kmani314/wearables/watch/pretty/CM7V-XTAL/CM7V-T1A-32.768kHz-6pF-20PPM-TA-QC/3D/CM7V-T1A-32.768kHz-6pF-20PPM-TA-QC.stp

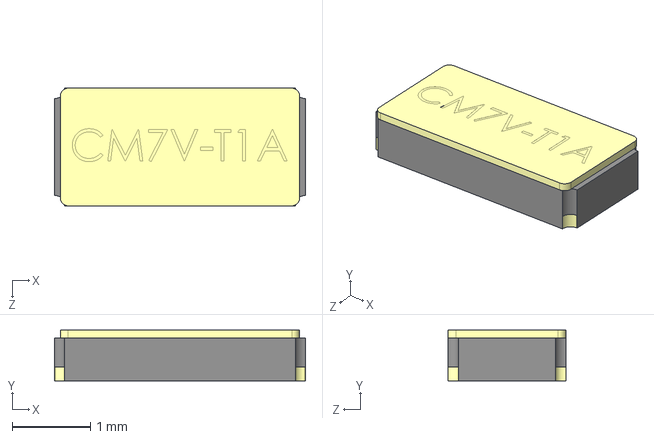
[picture p1: CAD file, 2023-06-11]
watch/pretty/CM7V-XTAL/CM7V-T1A-32.768kHz-6pF-20PPM-TA-QC/3D/CM7V-T1A-32.768kHz-6pF-20PPM-TA-QC.stp
3.20 x 0.65 x 1.50 mm
