kmani314/wearables/watch/pretty/EVP-ATAL1B000/3D/EVP-ATAL1B000.stp

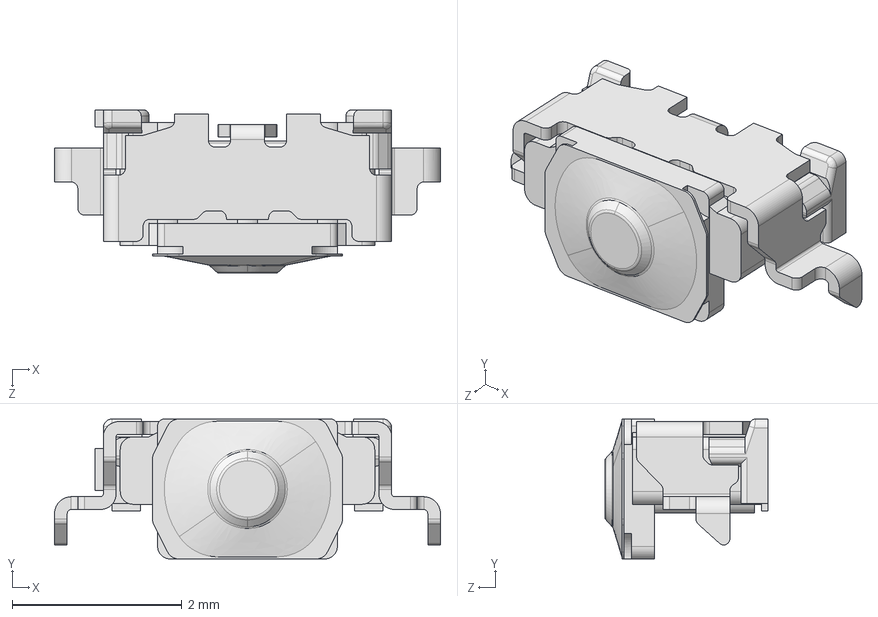
[picture p2: CAD file, 2023-06-11]
watch/pretty/EVP-ATAL1B000/3D/EVP-ATAL1B000.stp
4.55 x 1.65 x 1.93 mm
