kmani314/wearables/watch/pretty/FA-128_32.0000MF10Z-AJ5/3D/FA-128_32.0000MF10Z-AJ5.stp

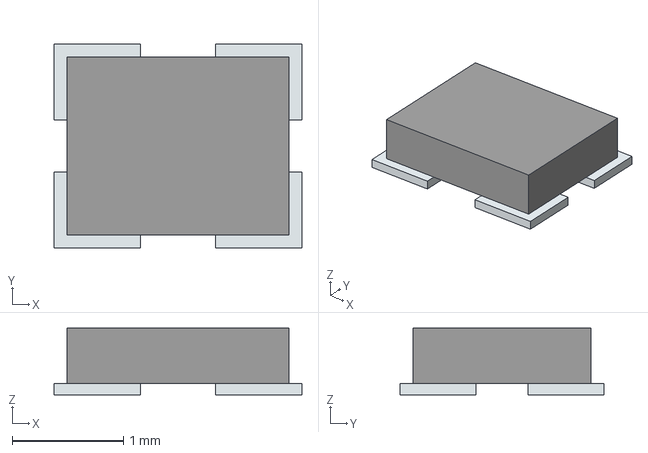
[picture p3: CAD file, 2023-06-11]
watch/pretty/FA-128_32.0000MF10Z-AJ5/3D/FA-128_32.0000MF10Z-AJ5.stp
2.23 x 1.83 x 0.6 mm
Pins
