kmani314/wearables/watch/pretty/MAX-M10S-00B/MAX-M10S-00B/3D/MAX-M10S-00B.stp

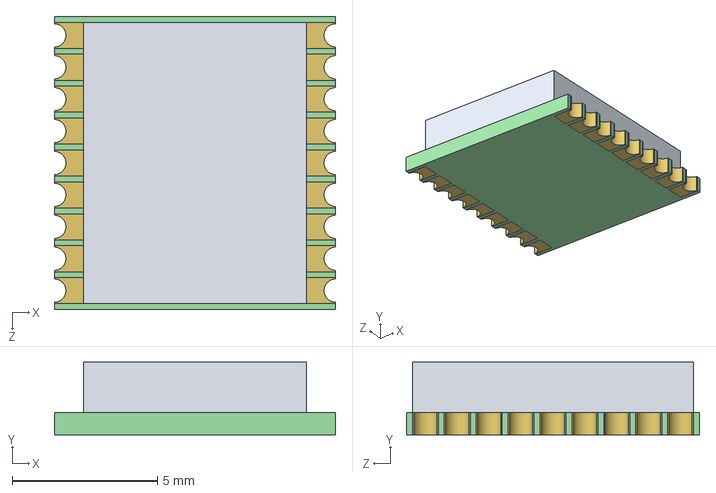
[picture p4: CAD file, 2023-06-11]
watch/pretty/MAX-M10S-00B/MAX-M10S-00B/3D/MAX-M10S-00B.stp
9.70 x 2.50 x 10.1 mm
