kmani314/wearables/watch/pretty/TXS0108ERGYR/TXS0108ERGYR/3D/TXS0108ERGYR.stp

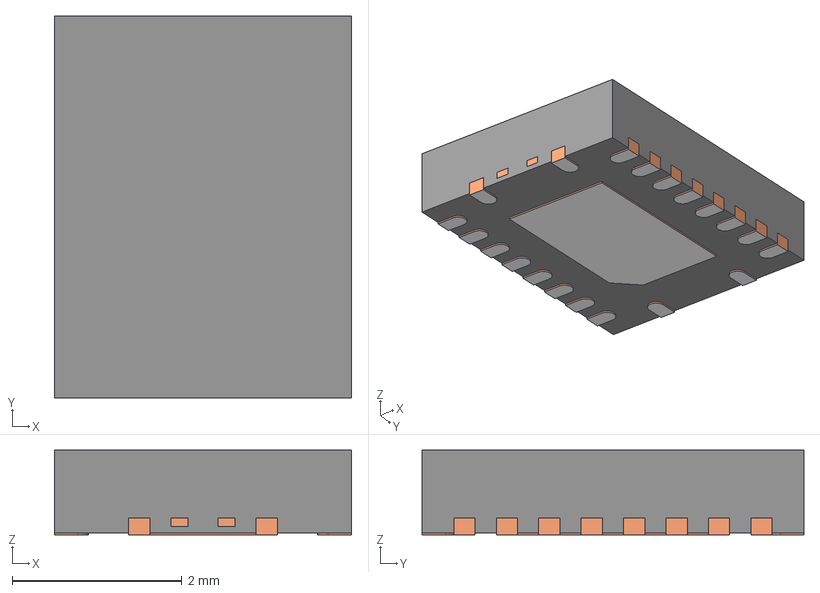
[picture p5: CAD file, 2023-06-09]
watch/pretty/TXS0108ERGYR/TXS0108ERGYR/3D/TXS0108ERGYR.stp
3.50 x 4.50 x 1.00 mm
BODY-QFN
FRAME-RGY0020A
PIN1-ID
