kmani314/wearables/watch/pretty/type-c-31-m-12/TYPE-C-31-M-12.step

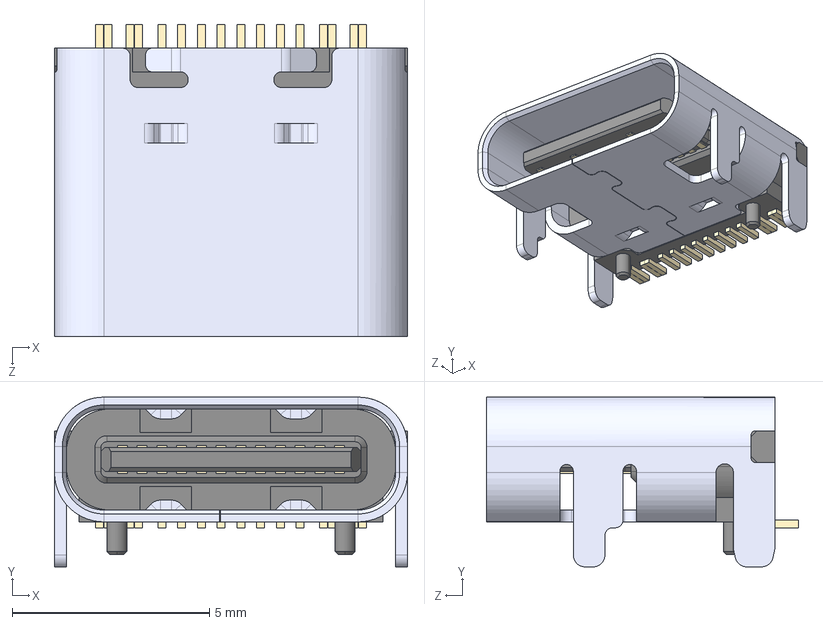
[picture p6: CAD file, 2023-06-08]
watch/pretty/type-c-31-m-12/TYPE-C-31-M-12.step
8.94 x 4.30 x 7.90 mm
