kmani314/wearables/watch/pretty/VEMD5080X01/VEMD5080X01/3D/VEMD5080X01.stp

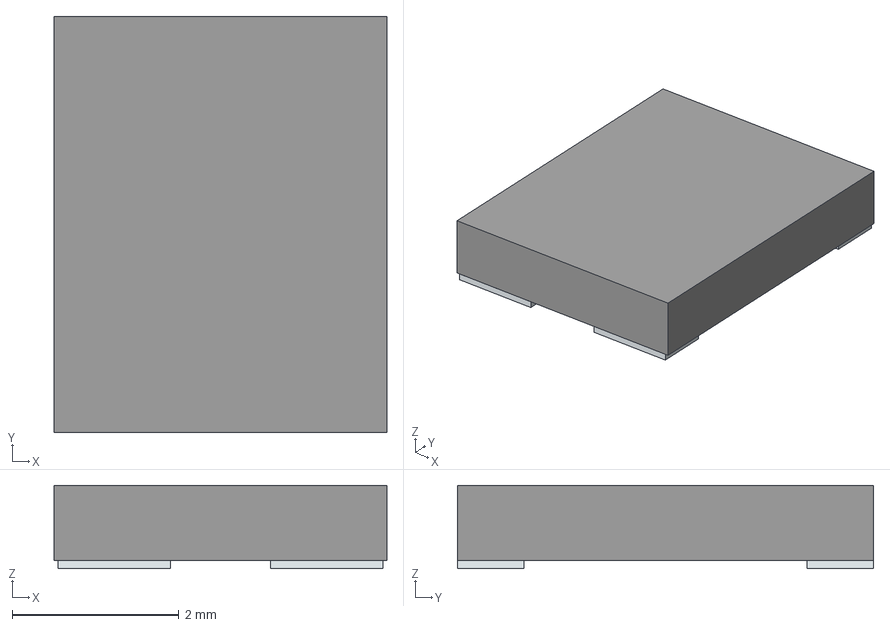
[picture p7: CAD file, 2023-06-08]
watch/pretty/VEMD5080X01/VEMD5080X01/3D/VEMD5080X01.stp
4.00 x 5.00 x 1.00 mm
Pins
