kmani314/wearables/watch/pretty/MAX31341CETB+T/3D/MAX31341CETB+T.stp

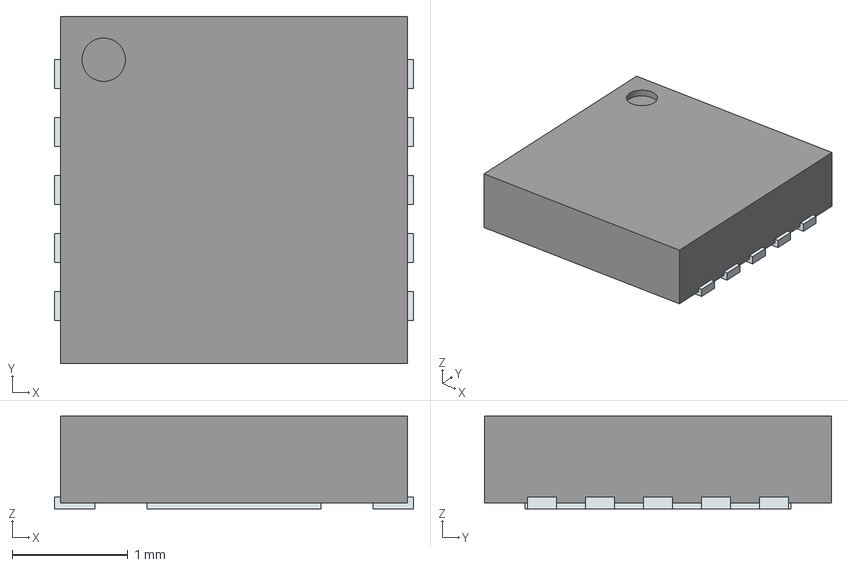
[picture p8: CAD file, 2023-06-13]
watch/pretty/MAX31341CETB+T/3D/MAX31341CETB+T.stp
3.10 x 3.00 x 0.8 mm
ThermalPin
PinsArrayLR
