kmani314/wearables/watch/pretty/max77659aenv+/MAX77659AENV+/3D/MAX77659AENV+.stp

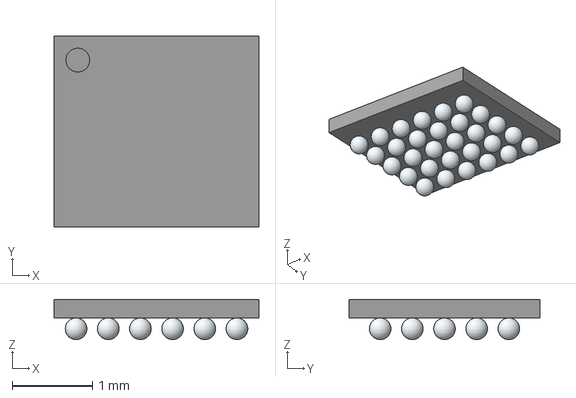
[picture p9: CAD file, 2023-06-08]
watch/pretty/max77659aenv+/MAX77659AENV+/3D/MAX77659AENV+.stp
2.55 x 2.37 x 0.5 mm
