kmani314/wearables/watch/pretty/max86141/MAX86141ENP+T/3D/MAX86141ENP+T.stp

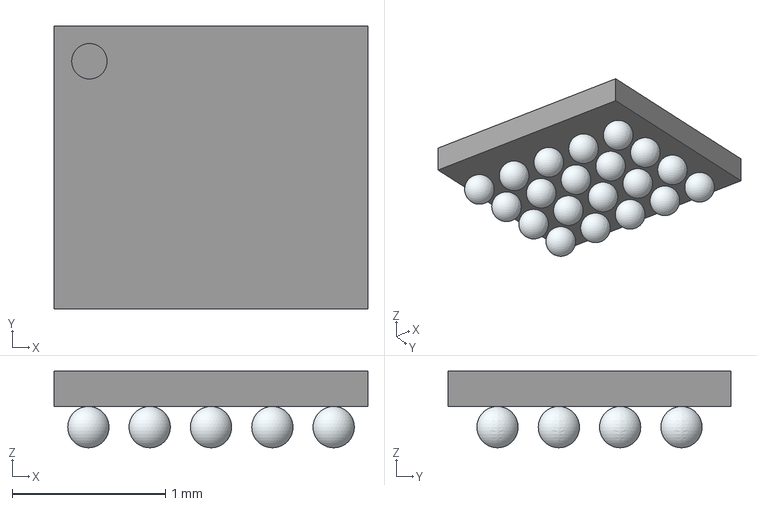
[picture p10: CAD file, 2023-06-08]
watch/pretty/max86141/MAX86141ENP+T/3D/MAX86141ENP+T.stp
2.05 x 1.85 x 0.5 mm
