kmani314/wearables/watch/pretty/molex_505110-2291/505110-2291/3D/505110-2291.stp

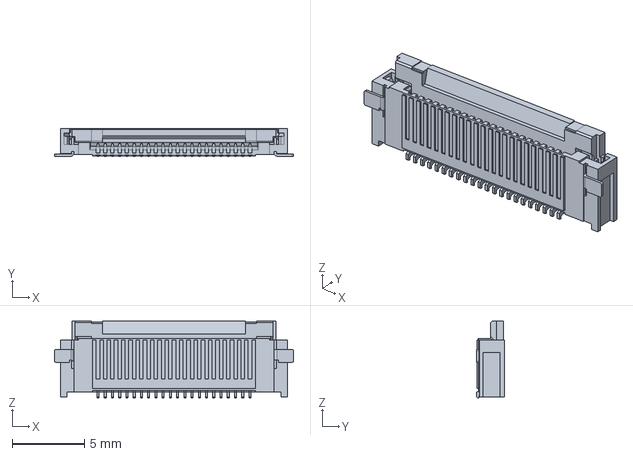
[picture p11: CAD file, 2023-06-08]
watch/pretty/molex_505110-2291/505110-2291/3D/505110-2291.stp
16.5 x 1.90 x 5.30 mm
