kmani314/wearables/(list of files, cad)

Other CAD files:
watch/pretty/CM7V-XTAL/CM7V-T1A-32.768kHz-6pF-20PPM-TA-QC/Allegro/cm7v32768tbqa020.psm
watch/pretty/CM7V-XTAL/CM7V-T1A-32.768kHz-6pF-20PPM-TA-QC/DEHDL/cm7v_t1a_32.768khz_6pf_20ppm_ta_qc/chips/chips.prt
watch/pretty/EVP-ATAL1B000/Allegro/evpatal1b000.psm
watch/pretty/EVP-ATAL1B000/DEHDL/evp_atal1b000/chips/chips.prt
watch/pretty/FA-128_32.0000MF10Z-AJ5/Allegro/fa128320000mf10zaj5.psm
watch/pretty/FA-128_32.0000MF10Z-AJ5/DEHDL/fa_128_32.0000mf10z_aj5/chips/chips.prt
watch/pretty/MAX-M10S-00B/MAX-M10S-00B/Allegro/maxm10s00b.psm
watch/pretty/MAX-M10S-00B/MAX-M10S-00B/DEHDL/max_m10s_00b/chips/chips.prt
watch/pretty/MAX31341CETB+T/Allegro/son50p300x300x80-11n.psm
watch/pretty/MAX31341CETB+T/DEHDL/max31341cetb_t/chips/chips.prt
watch/pretty/TXS0108ERGYR/TXS0108ERGYR/Allegro/sn74lvc541argyr.psm
watch/pretty/TXS0108ERGYR/TXS0108ERGYR/DEHDL/txs0108ergyr/chips/chips.prt
watch/pretty/VEMD5080X01/VEMD5080X01/Allegro/vemd5080x01.psm
watch/pretty/VEMD5080X01/VEMD5080X01/DEHDL/vemd5080x01/chips/chips.prt
watch/pretty/VLMO20J2M1/VLMO20J2M1-GS08/Allegro/ledm2214x140n.psm
watch/pretty/VLMO20J2M1/VLMO20J2M1-GS08/DEHDL/vlmo20j2m1_gs08/chips/chips.prt
watch/pretty/max32264/MAX32664GTGC+T/Allegro/max32664gtgc.psm
watch/pretty/max32264/MAX32664GTGC+T/DEHDL/max32664gtgc_t/chips/chips.prt
watch/pretty/max77659aenv+/MAX77659AENV+/Allegro/bga30c40p6x5_255x237x50.psm
watch/pretty/max77659aenv+/MAX77659AENV+/DEHDL/max77659aenv_/chips/chips.prt
watch/pretty/max86141/MAX86141ENP+T/Allegro/bga20c40p5x4_205x185x50.psm
watch/pretty/max86141/MAX86141ENP+T/DEHDL/max86141enp_t/chips/chips.prt
watch/pretty/molex_505110-2291/505110-2291/Allegro/5051102291.psm
watch/pretty/molex_505110-2291/505110-2291/DEHDL/505110_2291/chips/chips.prt
