kmani314/wearables/(list of files, drawings)

Other design files:
watch/pretty/EVP-ATAL1B000/Altium/EVP-ATAL1B000.SchLib
watch/pretty/EVP-ATAL1B000/Altium/EVPATAL1B000.PcbLib
watch/pretty/FA-128_32.0000MF10Z-AJ5/Altium/FA128320000MF10ZAJ5.PcbLib
watch/pretty/FA-128_32.0000MF10Z-AJ5/Altium/FA-128_32.0000MF10Z-AJ5.SchLib
watch/pretty/MAX31341CETB+T/Altium/MAX31341CETB+T.SchLib
watch/pretty/MAX31341CETB+T/Altium/SON50P300X300X80-11N.PcbLib
watch/pretty/max77659aenv+/MAX77659AENV+/Altium/BGA30C40P6X5_255X237X50.PcbLib
watch/pretty/max77659aenv+/MAX77659AENV+/Altium/MAX77659AENV+.SchLib
watch/pretty/max86141/MAX86141ENP+T/Altium/BGA20C40P5X4_205X185X50.PcbLib
watch/pretty/max86141/MAX86141ENP+T/Altium/MAX86141ENP+T.SchLib
watch/pretty/molex_505110-2291/505110-2291/Altium/505110-2291.SchLib
watch/pretty/molex_505110-2291/505110-2291/Altium/5051102291.PcbLib
watch/pretty/VEMD5080X01/VEMD5080X01/Altium/VEMD5080X01.PcbLib
watch/pretty/VEMD5080X01/VEMD5080X01/Altium/VEMD5080X01.SchLib
watch/pretty/VLMO20J2M1/VLMO20J2M1-GS08/Altium/LEDM2214X140N.PcbLib
watch/pretty/VLMO20J2M1/VLMO20J2M1-GS08/Altium/VLMO20J2M1-GS08.SchLib
