kmani314/wearables/watch/watch.kicad_pcb

## KiCad design watch/watch.kicad_pcb (2023-06-17)

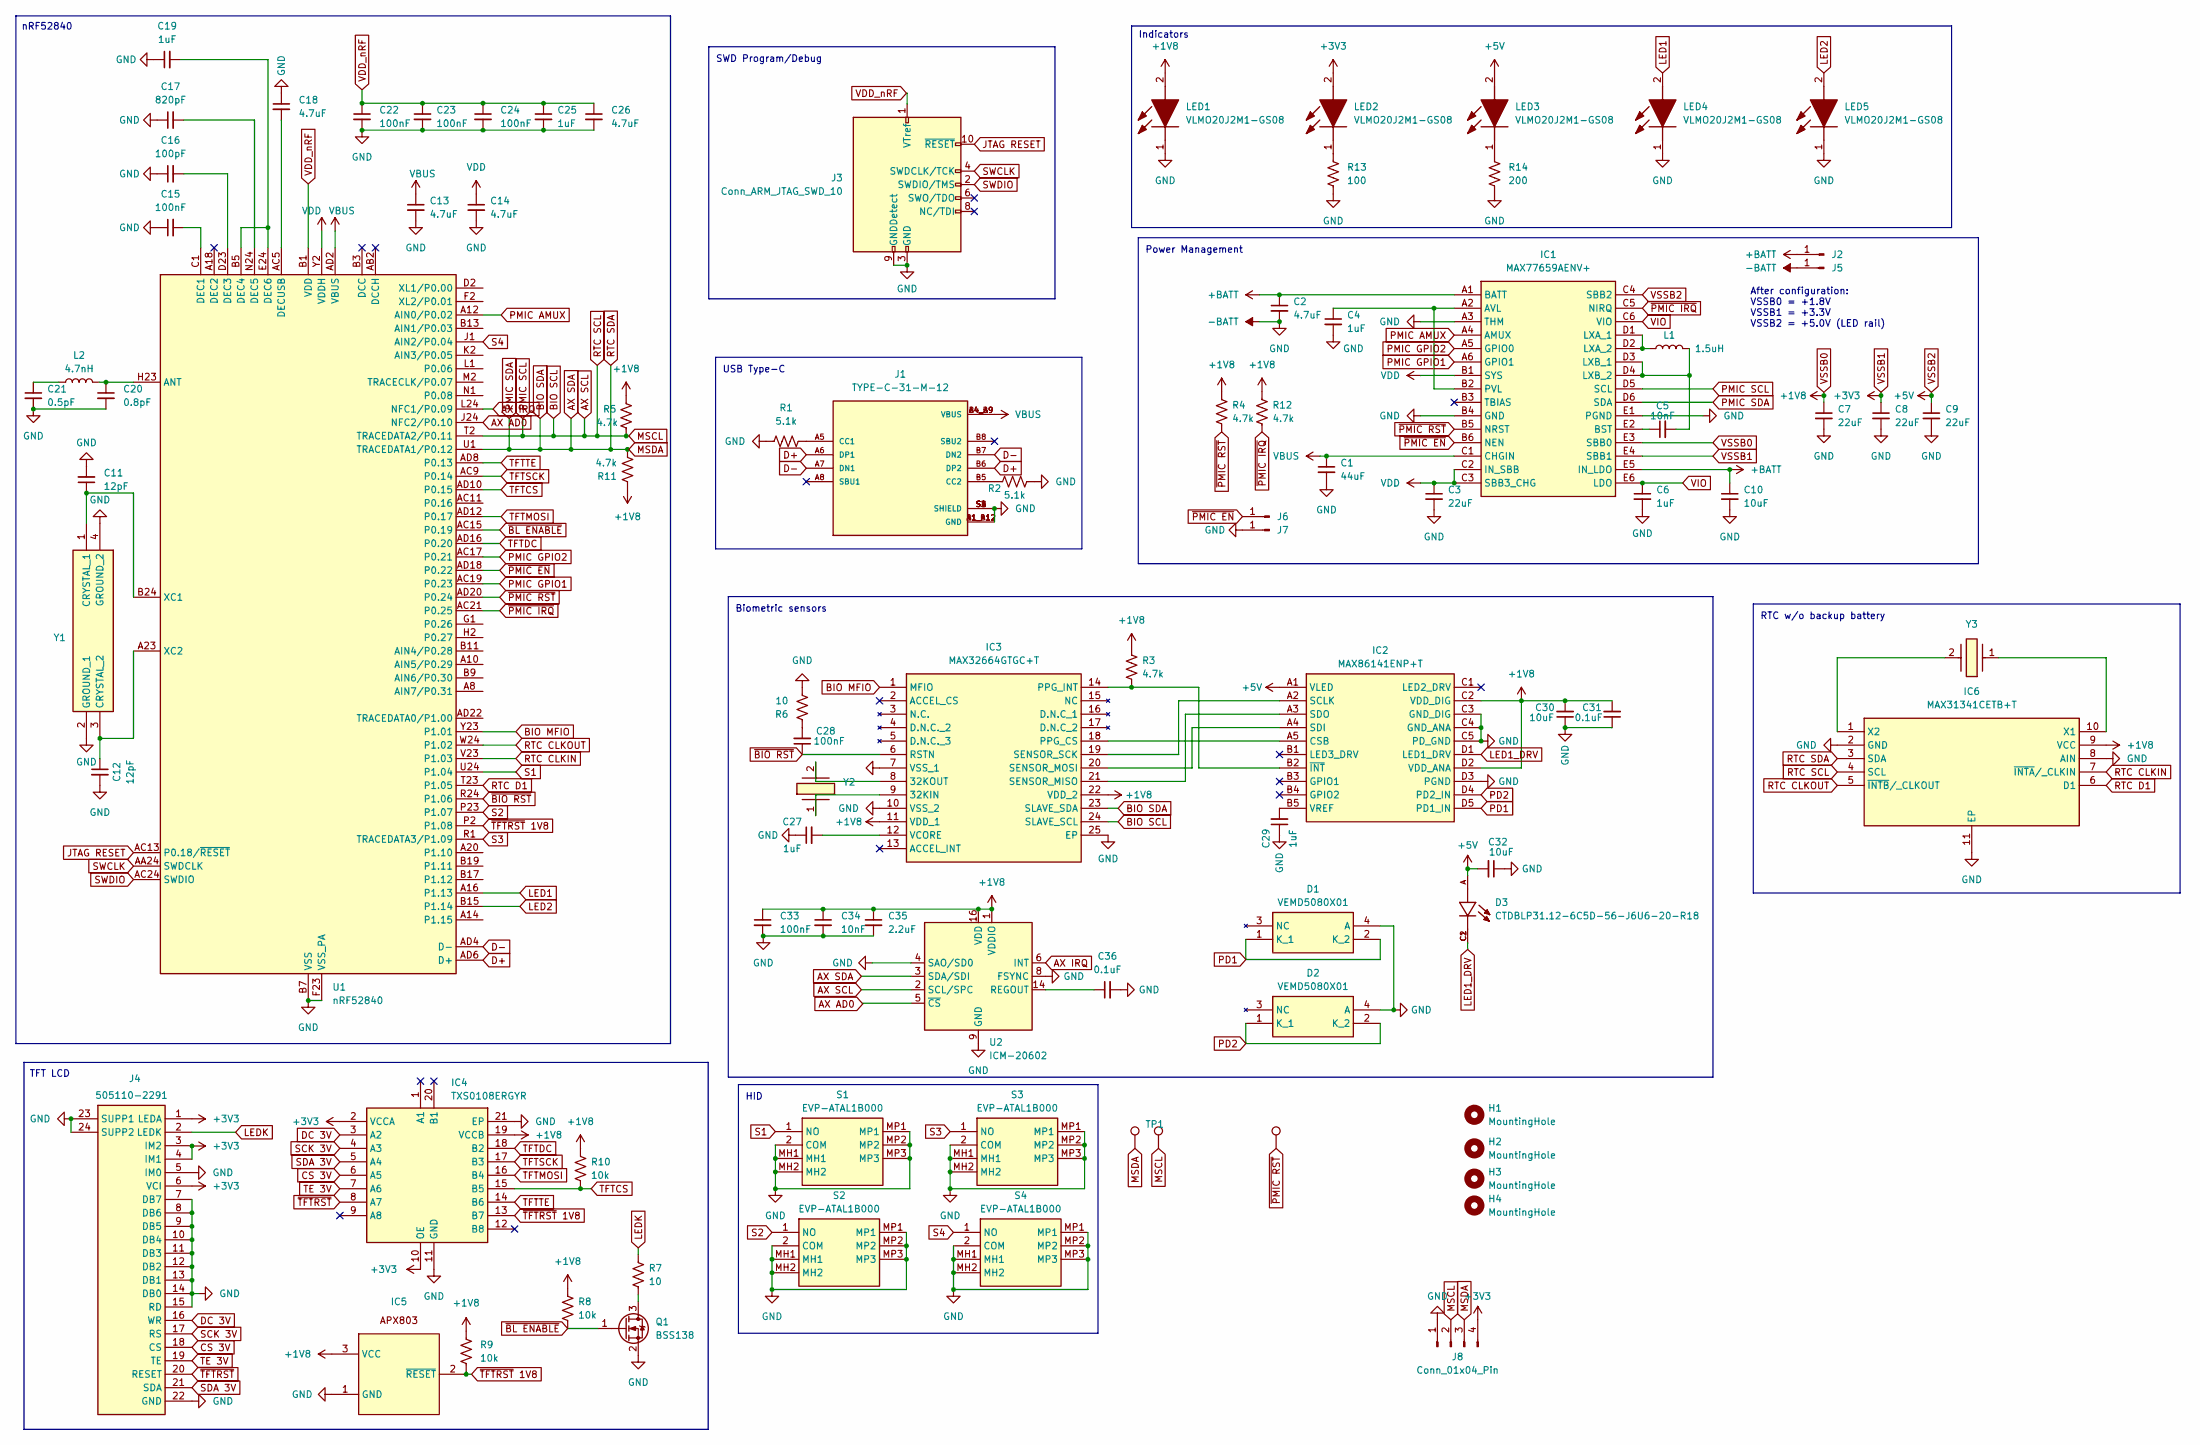
[picture p12: schematic watch.kicad_sch]

Parts:
C1: 44uF; C_0603_1608Metric_Pad1.08x0.95mm_HandSolder
C2, C13, C14, C18, C26: 4.7uF; C_0603_1608Metric_Pad1.08x0.95mm_HandSolder
C3, C7, C8, C9: 22uF; C_0603_1608Metric_Pad1.08x0.95mm_HandSolder
C4, C6: 1uF; C_0402_1005Metric_Pad0.74x0.62mm_HandSolder
C5: 10nF; C_0201_0603Metric_Pad0.64x0.40mm_HandSolder
C10, C30, C32: 10uF; C_0603_1608Metric_Pad1.08x0.95mm_HandSolder
C11, C12: 12pF; C_0402_1005Metric_Pad0.74x0.62mm_HandSolder
C15, C22, C23, C24, C28, C33: 100nF; C_0402_1005Metric_Pad0.74x0.62mm_HandSolder
C16: 100pF; C_0402_1005Metric_Pad0.74x0.62mm_HandSolder
C17: 820pF; C_0402_1005Metric_Pad0.74x0.62mm_HandSolder
C19, C25, C27, C29: 1uF; C_0603_1608Metric_Pad1.08x0.95mm_HandSolder
C20: 0.8pF; C_0402_1005Metric_Pad0.74x0.62mm_HandSolder
C21: 0.5pF; C_0402_1005Metric_Pad0.74x0.62mm_HandSolder
C31, C36: 0.1uF; C_0402_1005Metric_Pad0.74x0.62mm_HandSolder
C34: 10nF; C_0402_1005Metric_Pad0.74x0.62mm_HandSolder
C35: 2.2uF; C_0603_1608Metric_Pad1.08x0.95mm_HandSolder
D1, D2: VEMD5080X01; Mouser Part Number 78-VEMD5080X01
D3: CTDBLP31.12-6C5D-56-J6U6-20-R18; LED_CTDBLP31.12-6C5D-56-J6U6-20-R18; PARTREV 1.2
H1, H2, H3, H4: MountingHole; watch-housing
IC1: MAX77659AENV+; BGA30C40P6X5_255X237X50; Mouser Part Number 700-MAX77659AENV+
IC2: MAX86141ENP+T; BGA20C40P5X4_205X185X50; Mouser Part Number 700-MAX86141ENP+T
IC3: MAX32664GTGC+T; MAX32664GTGC; Mouser Part Number 700-MAX32664GTGC+T
IC4: TXS0108ERGYR; SN74LVC541ARGYR; Mouser Part Number 595-TXS0108ERGYR
IC5: SOT-23-3
IC6: MAX31341CETB+T; SON50P300X300X80-11N; Mouser Part Number 700-MAX31341CETB+T
J1: TYPE-C-31-M-12; HRO_TYPE-C-31-M-12; PARTREV 2020.12.08
J2, J5: Conn_01x01_Pin; TestPoint_Pad_4.0x4.0mm
J3: Conn_ARM_JTAG_SWD_10; Tag-Connect_TC2050-IDC-FP_2x05_P1.27mm_Vertical
J4: 505110-2291; 5051102291; Mouser Part Number 538-505110-2291
J6, J7: Conn_01x01_Pin; TestPoint_Pad_1.5x1.5mm
J8: Conn_01x04_Pin; PinHeader_1x04_P2.54mm_Vertical
L1: 1.5uH; L_0603_1608Metric_Pad1.05x0.95mm_HandSolder
L2: 4.7nH; L_0402_1005Metric_Pad0.77x0.64mm_HandSolder
LED1, LED2, LED3, LED4, LED5: VLMO20J2M1-GS08; LEDM2214X140N; Mouser Part Number 78-VLMO20J2M1
Q1: BSS138; SOT-23
R1, R2: 5.1k; R_0201_0603Metric_Pad0.64x0.40mm_HandSolder
R3, R4, R5, R11, R12: 4.7k; R_0201_0603Metric_Pad0.64x0.40mm_HandSolder
R6: 10; R_0201_0603Metric_Pad0.64x0.40mm_HandSolder
R7: 10; R_0805_2012Metric_Pad1.20x1.40mm_HandSolder
R8, R9, R10: 10k; R_0201_0603Metric_Pad0.64x0.40mm_HandSolder
R13: 100; R_0805_2012Metric_Pad1.20x1.40mm_HandSolder
R14: 200; R_0805_2012Metric_Pad1.20x1.40mm_HandSolder
S1, S2, S3, S4: EVP-ATAL1B000; EVPATAL1B000; Mouser Part Number 667-EVP-ATAL1B000
TP1, TP2, TP15: TestPoint; TestPoint_Pad_D1.0mm
U1: nRF52840; Nordic_AQFN-73-1EP_7x7mm_P0.5mm
U2: ICM-20602; LGA-16_3x3mm_P0.5mm_LayoutBorder3x5y
Y1: FA-128_32.0000MF10Z-AJ5; FA128320000MF10ZAJ5; Mouser Part Number 732-FA-12832MF10ZAJ5
Y2, Y3: CM7V-T1A-32.768kHz-6pF-20PPM-TA-QC; CM7V32768TBQA020; Mouser Part Number 428-201843-MG01

Connections:
+BATT: C2.1, C10.1, IC1.A1 (BATT), IC1.E5 (IN_LDO), J2.1
-BATT: C1.2, C2.2, C3.2, C4.2, C6.2, C7.2, C8.2, C9.2, C10.2, C11.2, C12.2, C13.2, C14.2, C15.1, C16.1, C17.1, C18.1, C19.1, C20.2, C21.2, C22.2, C23.2, C24.2, C25.2, C26.2, C27.1, C29.1, C30.1, C31.1, C32.1, C33.2, C34.2, C35.2, C36.2, D1.4 (A), D2.4 (A), IC1.A3 (THM), IC1.B4 (GND), IC1.E1 (PGND), IC2.C3 (GND_DIG), IC2.C4 (GND_ANA), IC2.C5 (PD_GND), IC2.D3 (PGND), IC3.7 (VSS_1), IC3.10 (VSS_2), IC3.25 (EP), IC4.11 (GND), IC4.21 (EP), IC5.1 (GND), IC6.2 (GND), IC6.8 (AIN), IC6.11 (EP), J1.A1_B12 (GND), J1.B1_A12 (GND), J1.S1 (SHIELD), J1.S2 (SHIELD), J1.S3 (SHIELD), J1.S4 (SHIELD), J3.3 (GND), J3.5 (GND), J3.9 (GNDDetect), J4.5 (IM0), J4.7 (DB7), J4.8 (DB6), J4.9 (DB5), J4.10 (DB4), J4.11 (DB3), J4.12 (DB2), J4.13 (DB1), J4.14 (DB0), J4.15 (RD), J4.22 (GND), J4.23 (SUPP1), J4.24 (SUPP2), J5.1, J7.1, J8.1, LED1.1 (K), LED4.1 (K), LED5.1 (K), Q1.2 (S), R1.1, R2.1, R6.1, R13.2, R14.2, S1.2 (COM), S1.MH1, S1.MH2, S1.MP1, S1.MP2, S1.MP3, S2.2 (COM), S2.MH1, S2.MH2, S2.MP1, S2.MP2, S2.MP3, S3.2 (COM), S3.MH1, S3.MH2, S3.MP1, S3.MP2, S3.MP3, S4.2 (COM), S4.MH1, S4.MH2, S4.MP1, S4.MP2, S4.MP3, U1.B7 (VSS), U1.EP (VSS), U1.F23 (VSS_PA), U2.4 (SAO/SD0), U2.8 (FSYNC), U2.9 (GND), U2.10 (GND), U2.11 (GND), U2.12 (GND), U2.13 (GND), U2.15 (GND), Y1.2 (GROUND_1), Y1.4 (GROUND_2)
AX AD0: U1.J24 (NFC2/P0.10), U2.5 (~CS)
AX IRQ: U1.L24 (NFC1/P0.09), U2.6 (INT)
AX SCL: IC1.D5 (SCL), IC3.24 (SLAVE_SCL), IC6.4 (SCL), J8.2, R5.2, TP2.1, U1.T2 (TRACEDATA2/P0.11), U2.2 (SCL/SPC)
AX SDA: IC1.D6 (SDA), IC3.23 (SLAVE_SDA), IC6.3 (SDA), J8.3, R11.2, TP1.1, U1.U1 (TRACEDATA1/P0.12), U2.3 (SDA/SDI)
BIO MFIO: IC3.1 (MFIO), U1.Y23 (P1.01)
CS 3V: IC4.6 (A5), J4.18 (CS)
D+: J1.A6 (DP1), J1.B6 (DP2), U1.AD6 (D+)
D-: J1.A7 (DN1), J1.B7 (DN2), U1.AD4 (D-)
DC 3V: IC4.3 (A2), J4.16 (WR)
JTAG RESET: J3.10 (~RESET), U1.AC13 (P0.18/~RESET)
LED1: LED4.2 (A), U1.A16 (P1.13)
LED1_DRV: D3.C1, D3.C2, IC2.D1 (LED1_DRV)
LED2: LED5.2 (A), U1.B15 (P1.14)
LEDK: J4.2 (LEDK), R7.1
unnamed: C21.1, L2.1
unnamed: C28.2, R6.2
unnamed: C4.1, IC1.A2 (AVL), IC1.B2 (PVL)
unnamed: C5.1, IC1.E2 (BST)
unnamed: IC1.D1 (LXA_1), IC1.D2 (LXA_2), L1.1
unnamed: C5.2, IC1.D3 (LXB_1), IC1.D4 (LXB_2), L1.2
unnamed: IC2.A5 (CSB), IC3.18 (PPG_CS)
unnamed: IC2.A2 (SCLK), IC3.19 (SENSOR_SCK)
unnamed: IC2.A4 (SDI), IC3.20 (SENSOR_MOSI)
unnamed: IC2.A3 (SDO), IC3.21 (SENSOR_MISO)
unnamed: C29.2, IC2.B5 (VREF)
unnamed: IC2.B2 (~INT), IC3.14 (PPG_INT), R3.2
unnamed: IC3.9 (32KIN), Y2.1
unnamed: IC3.8 (32KOUT), Y2.2
unnamed: C27.2, IC3.12 (VCORE)
unnamed: IC6.10 (X1), Y3.1
unnamed: IC6.1 (X2), Y3.2
unnamed: J1.A5 (CC1), R1.2
unnamed: J1.B5 (CC2), R2.2
unnamed: LED2.1 (K), R13.1
unnamed: LED3.1 (K), R14.1
unnamed: Q1.3 (D), R7.2
unnamed: C20.1, L2.2, U1.H23 (ANT)
unnamed: C15.2, U1.C1 (DEC1)
unnamed: C16.2, U1.D23 (DEC3)
unnamed: C19.2, U1.B5 (DEC4), U1.E24 (DEC6)
unnamed: C17.2, U1.N24 (DEC5)
unnamed: C18.2, U1.AC5 (DECUSB)
unnamed: C11.1, U1.B24 (XC1), Y1.1 (CRYSTAL_1)
unnamed: C12.1, U1.A23 (XC2), Y1.3 (CRYSTAL_2)
unnamed: C36.1, U2.14 (REGOUT)
PD1: D1.1 (K_1), D1.2 (K_2), IC2.D5 (PD1_IN)
PD2: D2.1 (K_1), D2.2 (K_2), IC2.D4 (PD2_IN)
PMIC AMUX: IC1.A4 (AMUX), U1.A12 (AIN0/P0.02)
PMIC GPIO1: IC1.A6 (GPIO1), U1.AC19 (P0.23)
PMIC GPIO2: IC1.A5 (GPIO0), U1.AC17 (P0.21)
RTC CLKIN: IC6.7 (~INTA/_CLKIN), U1.V23 (P1.03)
RTC CLKOUT: IC6.5 (~INTB/_CLKOUT), U1.W24 (P1.02)
RTC D1: IC6.6 (D1), U1.T23 (P1.05)
S1: S1.1 (NO), U1.U24 (P1.04)
S2: S2.1 (NO), U1.P23 (P1.07)
S3: S3.1 (NO), U1.R1 (TRACEDATA3/P1.09)
S4: S4.1 (NO), U1.J1 (AIN2/P0.04)
SCK 3V: IC4.4 (A3), J4.17 (RS)
SDA 3V: IC4.5 (A4), J4.21 (SDA)
SWCLK: J3.4 (SWDCLK/TCK), U1.AA24 (SWDCLK)
SWDIO: J3.2 (SWDIO/TMS), U1.AC24 (SWDIO)
TE 3V: IC4.7 (A6), J4.19 (TE)
TFTCS: IC4.15 (B5), R10.2, U1.AD10 (P0.15)
TFTDC: IC4.18 (B2), U1.AD16 (P0.20)
TFTMOSI: IC4.16 (B4), U1.AD12 (P0.17)
TFTSCK: IC4.17 (B3), U1.AC9 (P0.14)
TFTTE: IC4.14 (B6), U1.AD8 (P0.13)
VBUS: C1.1, C13.1, IC1.C1 (CHGIN), J1.A4_B9 (VBUS), J1.B4_A9 (VBUS), U1.AD2 (VBUS)
VDD: C3.1, C14.1, IC1.B1 (SYS), IC1.C2 (IN_SBB), IC1.C3 (SBB3_CHG), U1.Y2 (VDDH)
VDD_nRF: C22.1, C23.1, C24.1, C25.1, C26.1, J3.1 (VTref), U1.A22 (VDD), U1.AD14 (VDD), U1.AD23 (VDD), U1.B1 (VDD), U1.W1 (VDD)
VIO: C6.1, IC1.C6 (VIO), IC1.E6 (LDO)
VSSB0: C7.1, C30.2, C31.2, C33.1, C34.1, C35.1, IC1.E3 (SBB0), IC2.C2 (VDD_DIG), IC2.D2 (VDD_ANA), IC3.11 (VDD_1), IC3.22 (VDD_2), IC4.19 (VCCB), IC5.3 (VCC), IC6.9 (VCC), LED1.2 (A), R3.1, R4.1, R5.1, R8.1, R9.1, R10.1, R11.1, R12.1, U2.1 (VDDIO), U2.16 (VDD)
VSSB1: C8.1, IC1.E4 (SBB1), IC4.2 (VCCA), IC4.10 (OE), J4.1 (LEDA), J4.3 (IM2), J4.4 (IM1), J4.6 (VCI), J8.4, LED2.2 (A)
VSSB2: C9.1, C32.2, D3.A, IC1.C4 (SBB2), IC2.A1 (VLED), LED3.2 (A)
~BIO RST: C28.1, IC3.6 (RSTN), U1.R24 (P1.06)
~BL ENABLE: Q1.1 (G), R8.2, U1.AC15 (P0.19)
~PMIC EN: IC1.B6 (NEN), J6.1, U1.AD18 (P0.22)
~PMIC IRQ: IC1.C5 (NIRQ), R12.2, U1.AC21 (P0.25)
~PMIC RST: IC1.B5 (NRST), R4.2, TP15.1, U1.AD20 (P0.24)
~TFTRST: IC4.8 (A7), J4.20 (RESET)
~TFTRST 1V8: IC4.13 (B7), IC5.2 (~RESET), R9.2, U1.P2 (P1.08)

Notes on the sheet:
SWD Program/Debug
Power Management
RTC w/o backup battery
After configuration: VSSB0 = +1.8V VSSB1 = +3.3V VSSB2 = +5.0V (LED rail)
HID
TFT LCD
nRF52840
USB Type-C
Indicators
Biometric sensors

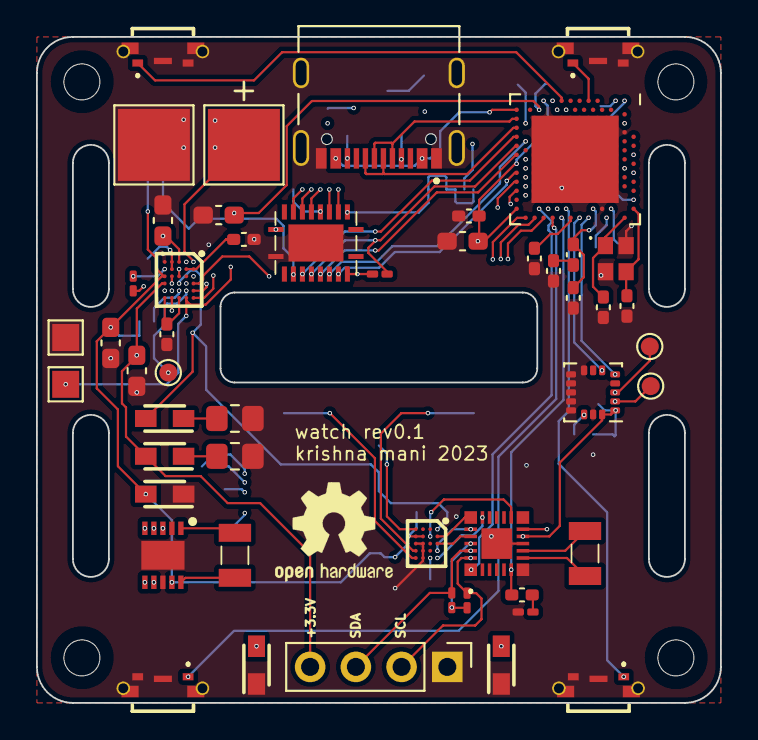
[picture p13: board watch.kicad_pcb from above]

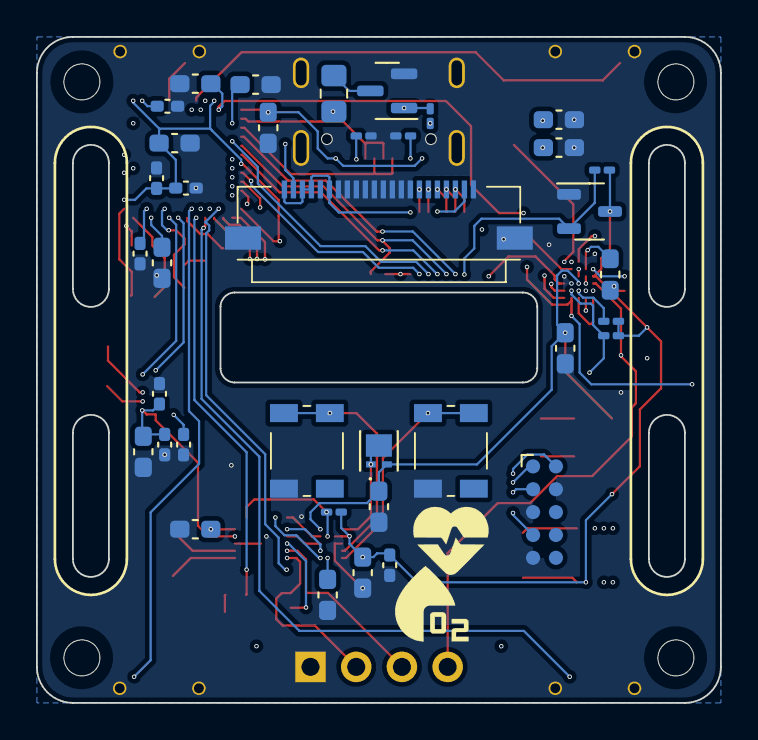
[picture p14: board watch.kicad_pcb from below]

Board: 4 copper layers, 38.0 x 37.0 mm, 91 parts (37 on the bottom side), 83 nets.
