kmani314/wearables/(commit log)

2023-06-08 lots of stuff: power management, uC power, USB
    [505110-2291.SchLib, 505110-2291.stp, 5051102291.PcbLib, 5051102291.psm, BGA20C40P5X4_205X185X50.PcbLib, BGA30C40P6X5_255X237X50.PcbLib, EDI2CAP.CFG, MAX32664GTGC+T.stp]
2023-06-08 organize and add display block, going to the gym
    [watch.kicad_sch]
2023-06-09 first rev done
    [EDI2CAP.CFG, TXS0108ERGYR.stp, chips.prt, sn74lvc541argyr.psm, watch.kicad_sch]
2023-06-11 parts finalized, started routing
    [CM7V-T1A-32.768kHz-6pF-20PPM-TA-QC.stp, EDI2CAP.CFG, EVP-ATAL1B000.SchLib, EVP-ATAL1B000.stp, EVPATAL1B000.PcbLib, FA-128_32.0000MF10Z-AJ5.SchLib, FA-128_32.0000MF10Z-AJ5.stp, FA128320000MF10ZAJ5.PcbLib]
2023-06-13 RTC, board started
    [EDI2CAP.CFG, MAX31341CETB+T.SchLib, MAX31341CETB+T.stp, SON50P300X300X80-11N.PcbLib, chips.prt, son50p300x300x80-11n.psm, watch.kicad_pcb]
2023-06-16 rev1 done absolutely does not pass drc need to add ci
    [watch.kicad_pcb, watch.kicad_sch]
2023-06-16 rev0.1 done, passes drc and jlc checks
    [watch.kicad_pcb, watch.kicad_sch]
2023-06-17 change mounting clearances, add expansion connector
    [watch.kicad_pcb, watch.kicad_sch]
